tharusha-pathirana/smart-pill-box/Simulation/screenshots/2 Time Screen.jpg

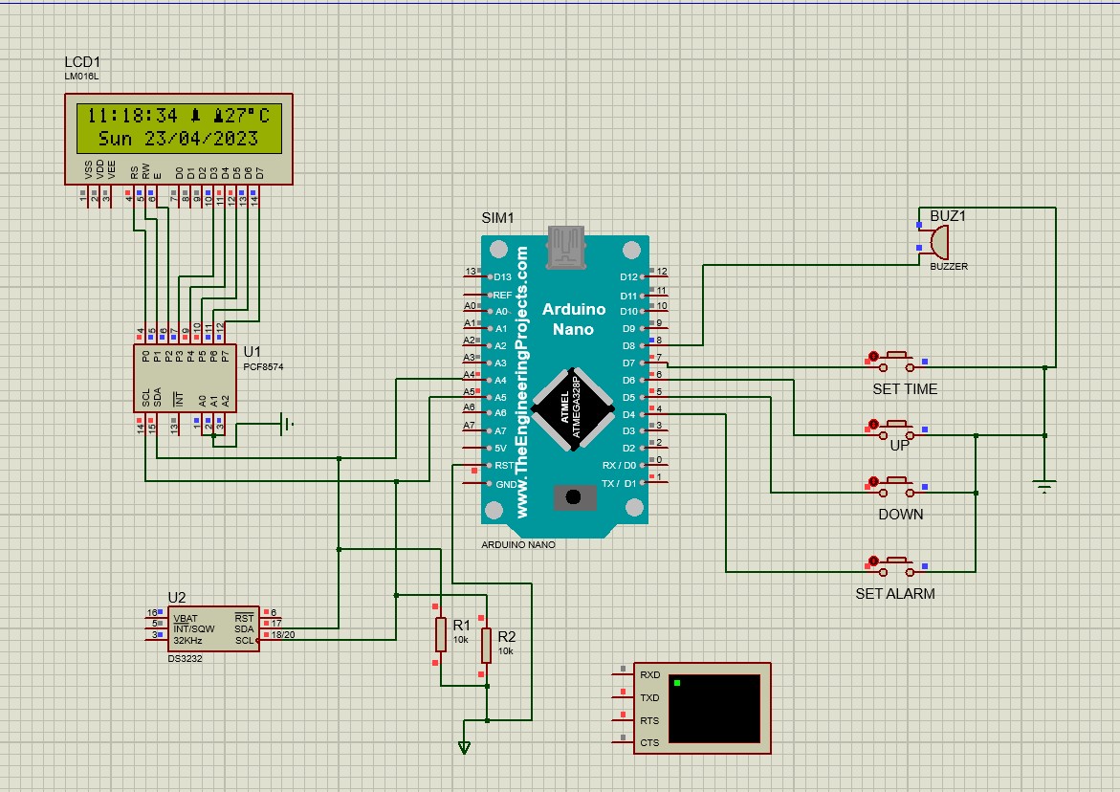
Simulation/screenshots/2 Time Screen.jpg
