tharusha-pathirana/smart-pill-box/Solidworks/LCD AP214.SLDASM

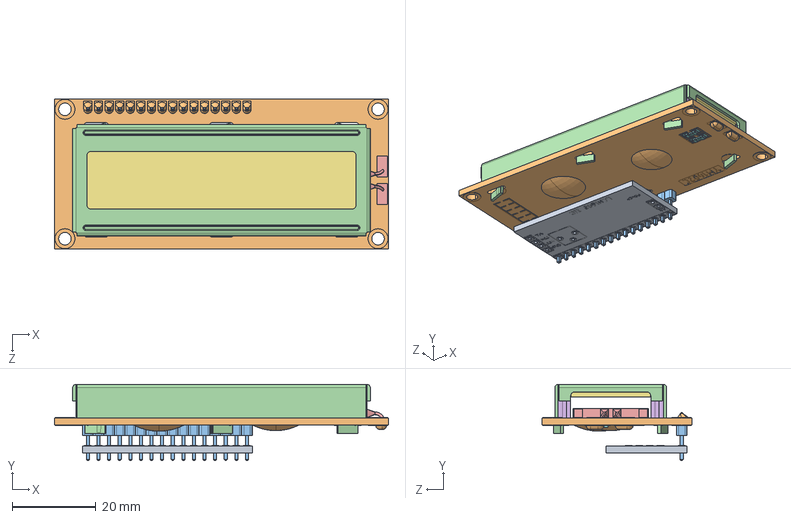
[picture p28: CAD file, 2023-09-11]
Solidworks/LCD AP214.SLDASM
80.0 x 18.3 x 36.0 mm
i2c board.STEP
pcbboard.STEP
16pin_header__.STEP
lcd window.STEP
backlight.STEP
conductor.STEP x 2
liquid crystal grabcad i2s.STEP
smt_resistor101.STEP x 2
