tharusha-pathirana/smart-pill-box/Solidworks/Pill box top.SLDPRT

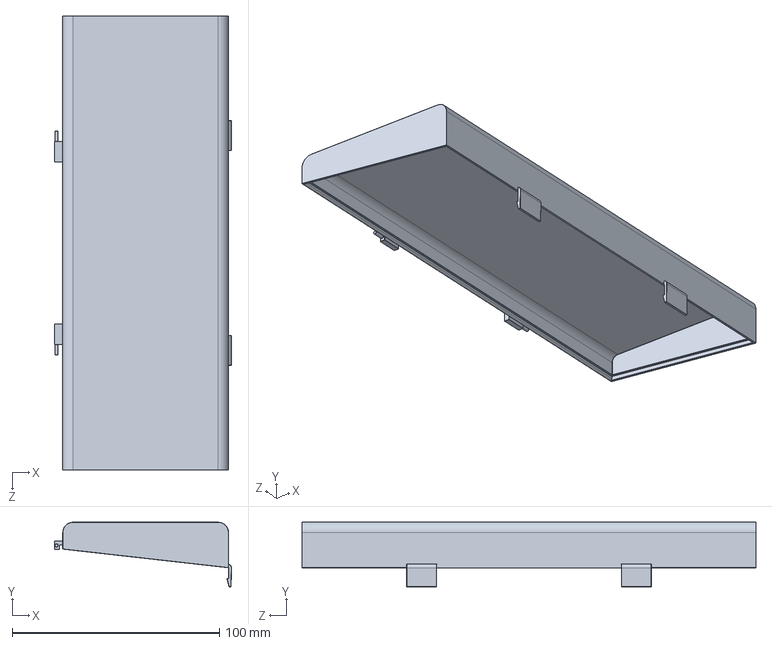
[picture p29: CAD file, 2023-09-11]
Solidworks/Pill box top.SLDPRT
85.4 x 31.2 x 219.0 mm
