tharusha-pathirana/smart-pill-box/Solidworks/Pill box case.SLDPRT

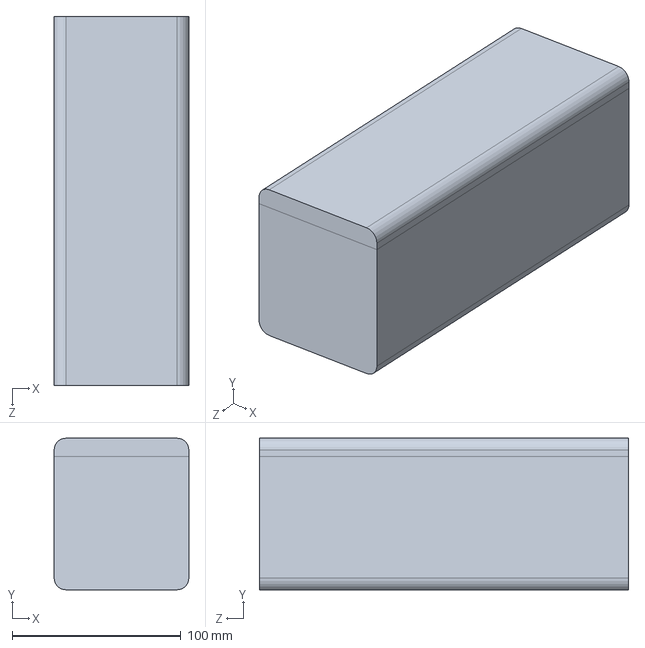
[picture p30: CAD file, 2023-09-11]
Solidworks/Pill box case.SLDPRT
80.0 x 90.0 x 219.0 mm
