tharusha-pathirana/smart-pill-box/Solidworks/top cover.SLDPRT

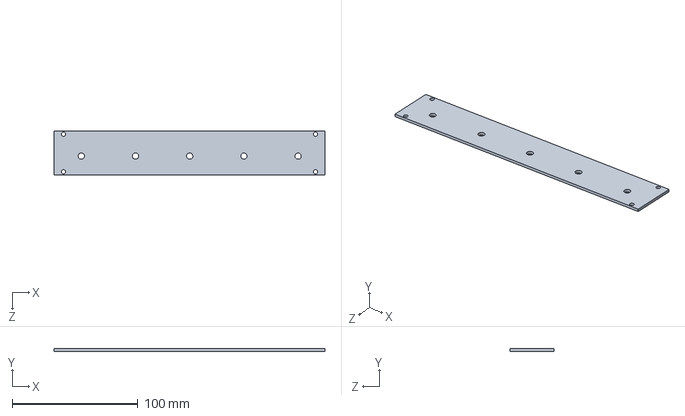
[picture p31: CAD file, 2023-09-11]
Solidworks/top cover.SLDPRT
215.1 x 2.00 x 34.9 mm
