tharusha-pathirana/smart-pill-box/Solidworks/Pill Box bottom.SLDPRT

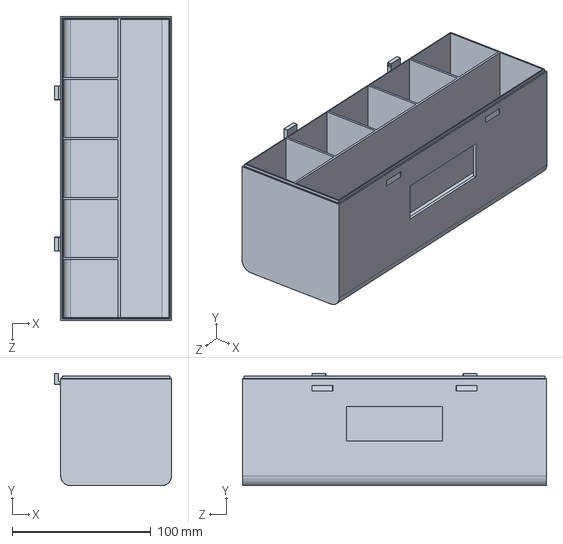
[picture p32: CAD file, 2023-09-11]
Solidworks/Pill Box bottom.SLDPRT
84.5 x 81.0 x 219.0 mm
