tharusha-pathirana/smart-pill-box/PCB/Schematics.pdf

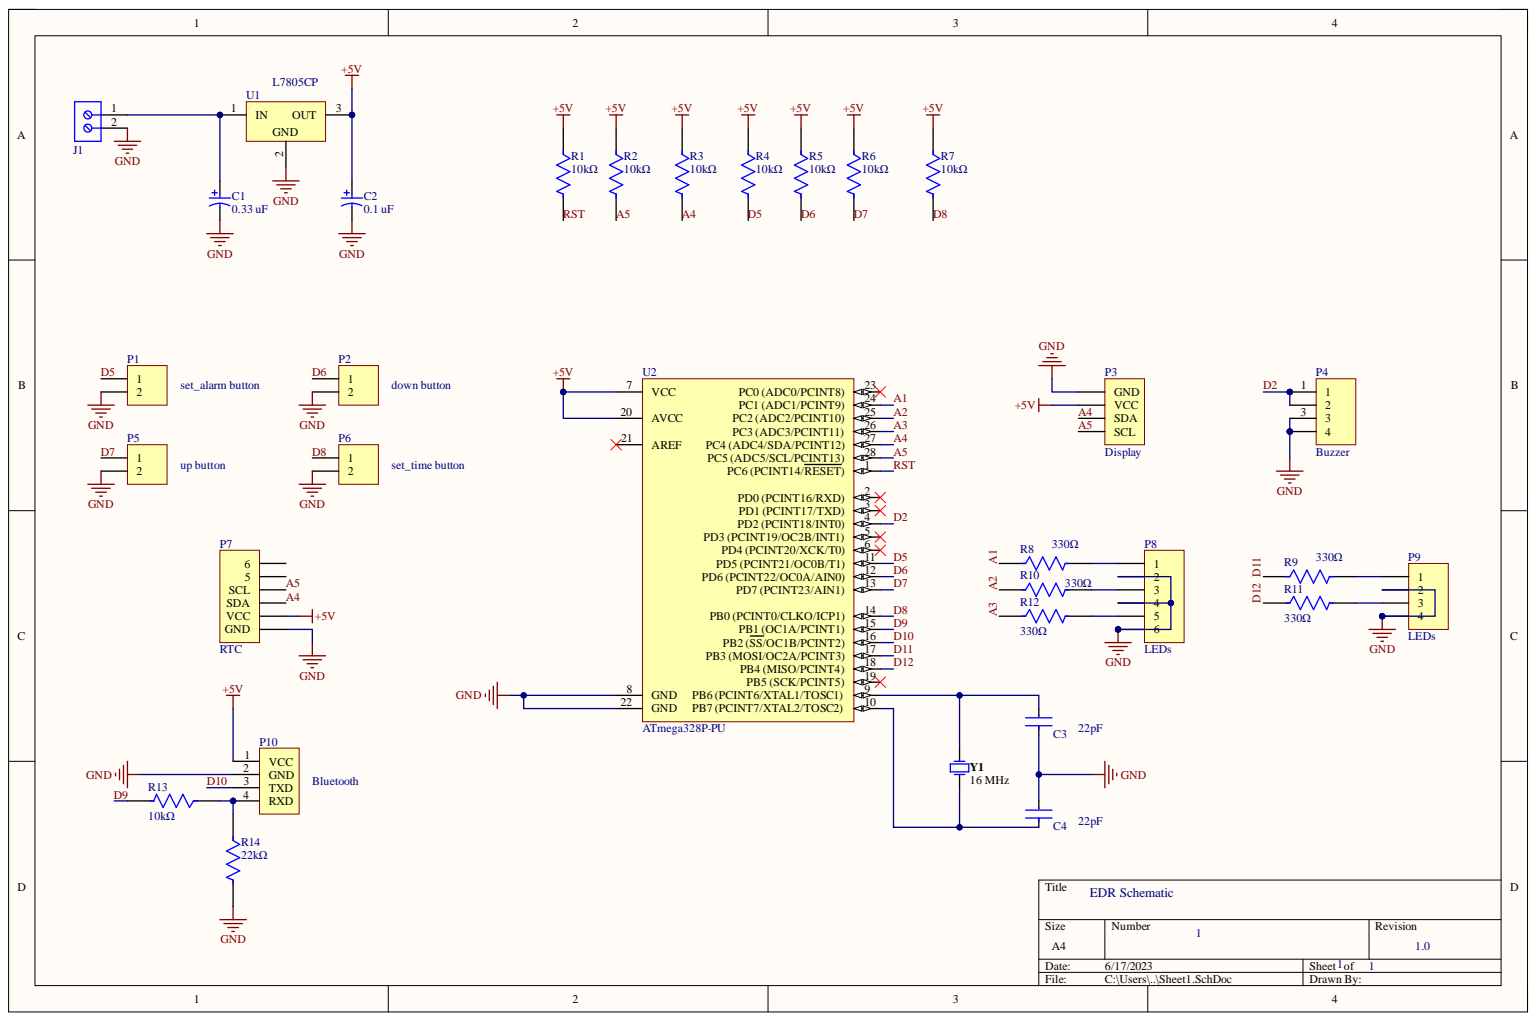
[picture p33: page 1]

4 5

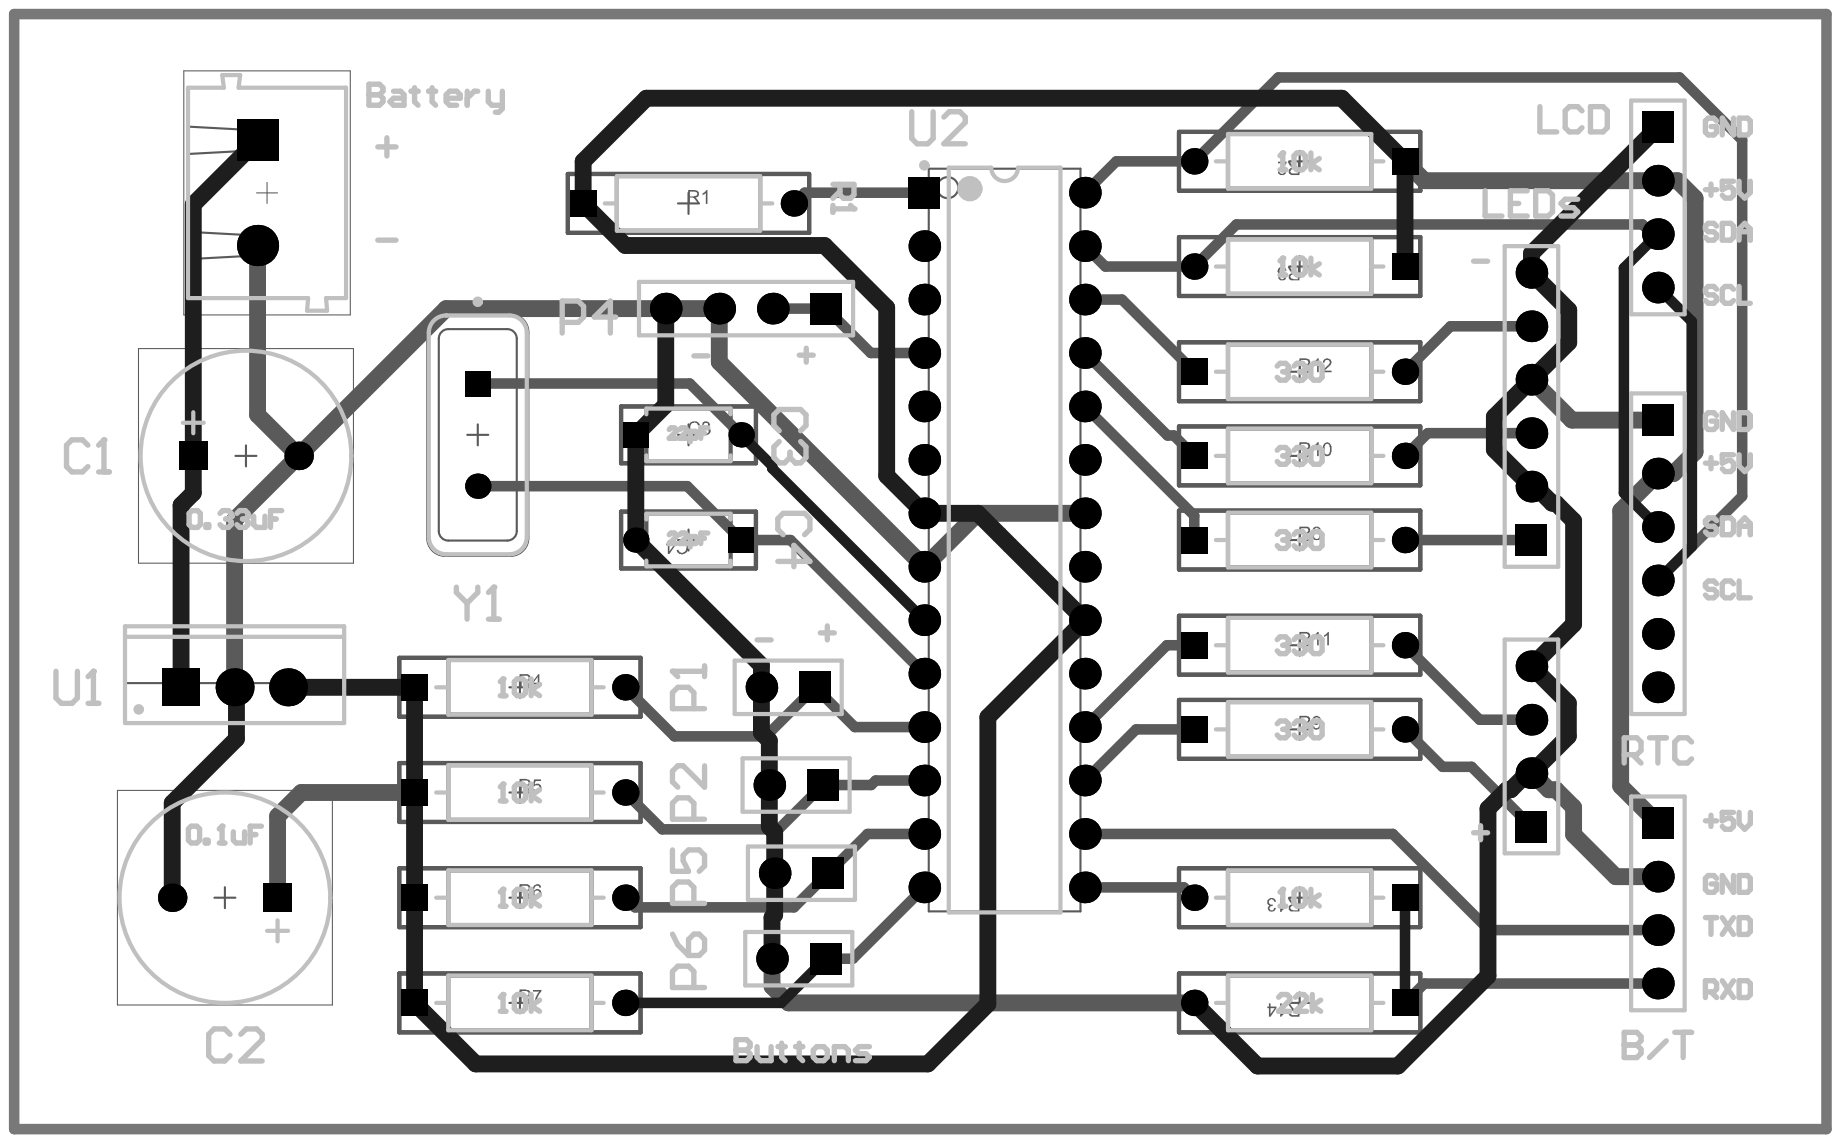
[picture p34: page 2]
