tharusha-pathirana/smart-pill-box/(list of files, drawings)

Other design files:
PCB/PCB1.PcbDoc
PCB/Sheet1.SchDoc
Simulation/pillbox_reminder.pdsprj
